Hellons-Dev/DoRobo-M2Project/Electronical_Schematic/README.md

# Here is the schematic of the robot and its electronical parts
