Hellons-Dev/DoRobo-M2Project/3D_Models/Tracks_Wheels/README.md

# Tracks and wheel have been found here :
https://www.thingiverse.com/thing:3680093
