Hellons-Dev/DoRobo-M2Project/Codes/FMReceiver/README.md

# Specifications
- FM Module : BRAVO-T868
- Board : STM32-F303K8
- MBed OS version : MBed 2
- Antenna : Antenna 1/4 wave length SMA 90deg 868MHz

# Version Details
- V0.1 : First test of data reading from FM module
- V0.2 : Second test with lot of errors but working half the time
- V1.1 : New technic for data reading on digital pins but not working
- V2.1 : Final version with difficulties to work has the FM module tend to reverse bytes half the time
