Hellons-Dev/DoRobo-M2Project/Codes/Lidar/FinalVersion/README.md

# Specifications
- Lidar : RPLidar A1M8
- Board : STM32-F446RE
- Library works with all RPLidar versions
