Hellons-Dev/DoRobo-M2Project/Documentations/RPLidarA1M8/README.md

# Link to part :
https://www.gotronic.fr/art-capteur-de-distance-rplidar-a1m8-29031.htm
