Hellons-Dev/DoRobo-M2Project/Documentations/STM32-L476RG/README.md

# Link to part :
https://fr.rs-online.com/web/p/outils-de-developpement-pour-microcontroleurs/8967721

# MBed Link :
https://os.mbed.com/platforms/ST-Nucleo-L476RG/
