Hellons-Dev/DoRobo-M2Project/Documentations/STM32-F446RE/README.md

# Link to part :
https://fr.rs-online.com/web/p/outils-de-developpement-pour-microcontroleurs/9064624/?sra=pmpn

# MBed Link :
https://os.mbed.com/platforms/ST-Nucleo-F446RE/
