Hellons-Dev/DoRobo-M2Project/Documentations/STM32-F303K8/README.md

# Link to part :
https://fr.rs-online.com/web/p/outils-de-developpement-pour-microcontroleurs/9092862

# MBed Link :
https://os.mbed.com/platforms/ST-Nucleo-F303K8/
