Hellons-Dev/DoRobo-M2Project/Documentations/Antenna/README.md

# Link to part :
https://fr.rs-online.com/web/p/antennes-de-telemetrie/0542563
