Hellons-Dev/DoRobo-M2Project/Documentations/PMod_HB3/README.md

# Link to part :
https://fr.rs-online.com/web/p/modules-de-developpement-pour-la-robotique-la-gestion-d-alimentation-et-les-moteurs/1346445
