Hellons-Dev/DoRobo-M2Project/3D_Models/SOLIDWORKS/Assem1.SLDASM

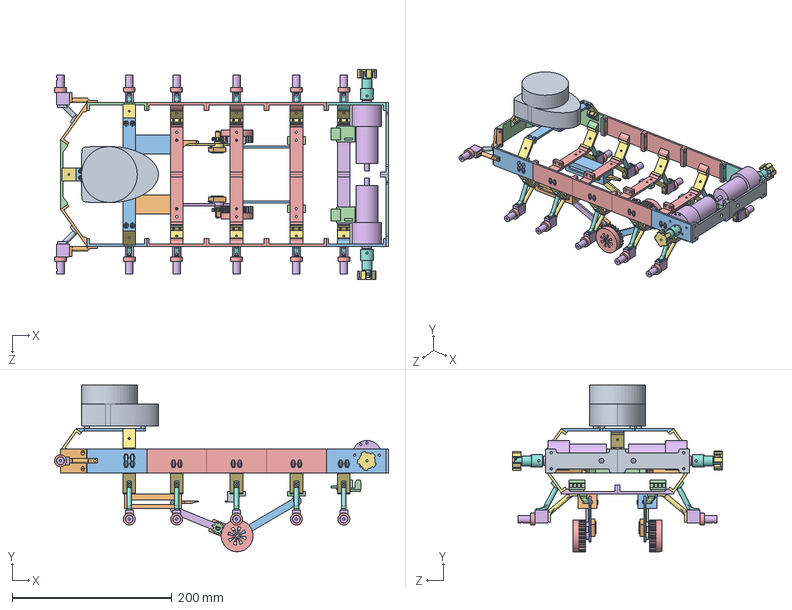
[picture p1: CAD file, 2023-03-26]
3D_Models/SOLIDWORKS/Assem1.SLDASM
418.7 x 208.8 x 263.8 mm
PHMod3 x 2
Robot
EncodingRotor x 2
Robot3 x 2
Robot_mirror
RobotB x 13
RobotBase x 2
Robot2 x 6
Robot4-mirror
Robot4
RobotFront1 x 2
LIDAR
WheelSupport1 x 10
WheelSupport2 x 10
WheelBlockBot x 12
RobotBase2 x 8
lidarBase
WheelSupportFront1 x 2
WheelSupportFront2 x 2
motorWheelAxis x 2
MotorWheelStop x 2
NewMotors x 2
WheelBlockExtender x 12
EncoderSupport1 x 2
Tube
TubeMirror
TubeHold2 x 2
TubeHold1 x 2
ArmENC
ArmENCMirror
SpurGearWheel x 2
SpurGearEnc x 2
ArmSupport x 2
springHolder
springHolder2
