Hellons-Dev/DoRobo-M2Project/3D_Models/SOLIDWORKS/WheelBlockBot.SLDPRT

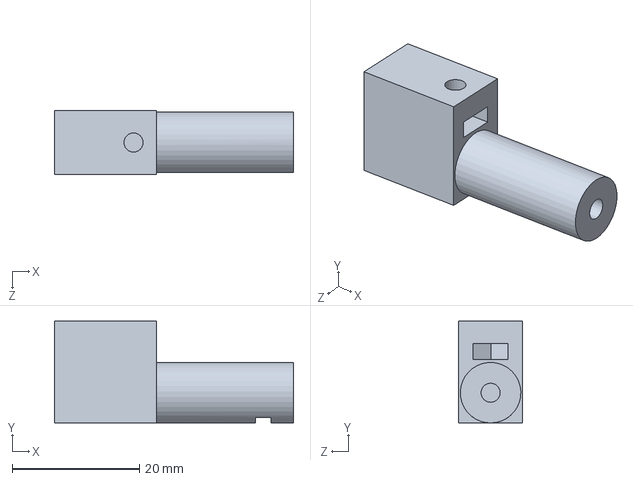
[picture p2: CAD file, 2023-03-26]
3D_Models/SOLIDWORKS/WheelBlockBot.SLDPRT
37.5 x 16.0 x 10.0 mm
