Hellons-Dev/DoRobo-M2Project/3D_Models/SOLIDWORKS/TubeHold2.SLDPRT

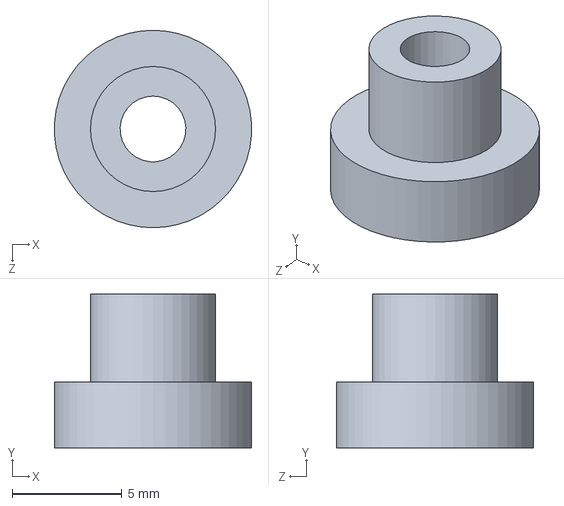
[picture p3: CAD file, 2023-03-26]
3D_Models/SOLIDWORKS/TubeHold2.SLDPRT
8.98 x 7.00 x 9.00 mm
