Hellons-Dev/DoRobo-M2Project/3D_Models/SOLIDWORKS/Face.SLDPRT

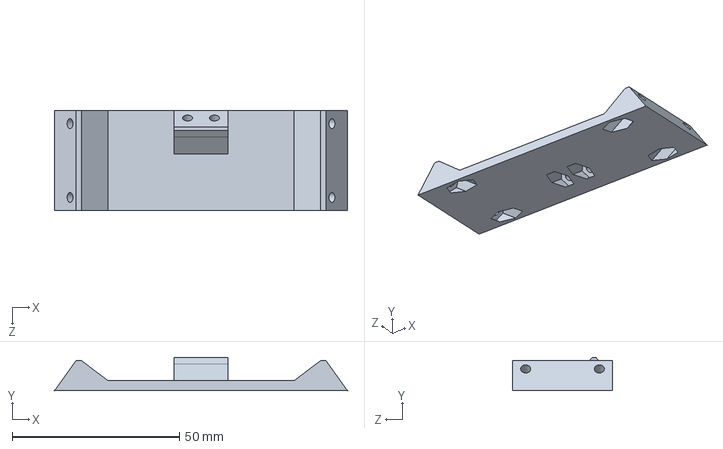
[picture p4: CAD file, 2023-03-26]
3D_Models/SOLIDWORKS/Face.SLDPRT
87.5 x 10.0 x 30.0 mm
