Hellons-Dev/DoRobo-M2Project/3D_Models/SOLIDWORKS/motorWheelAxis.SLDPRT

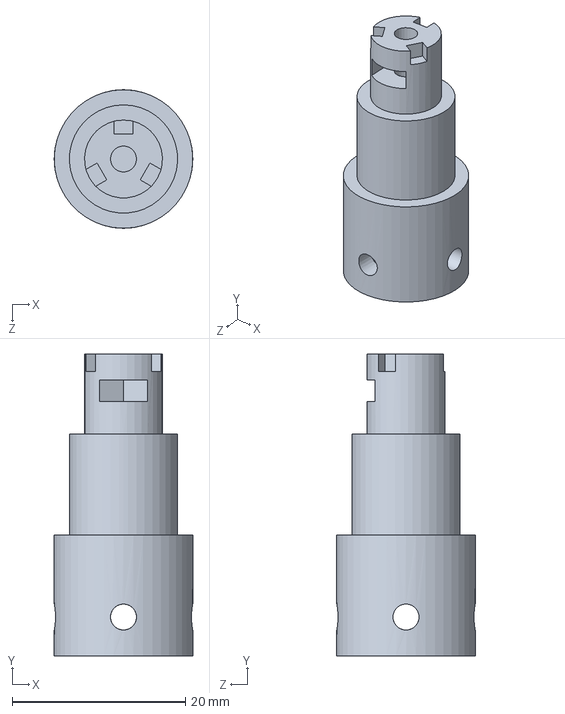
[picture p5: CAD file, 2023-03-26]
3D_Models/SOLIDWORKS/motorWheelAxis.SLDPRT
16.0 x 34.9 x 16.0 mm
