Hellons-Dev/DoRobo-M2Project/3D_Models/SOLIDWORKS/EncoderSupport1.SLDPRT

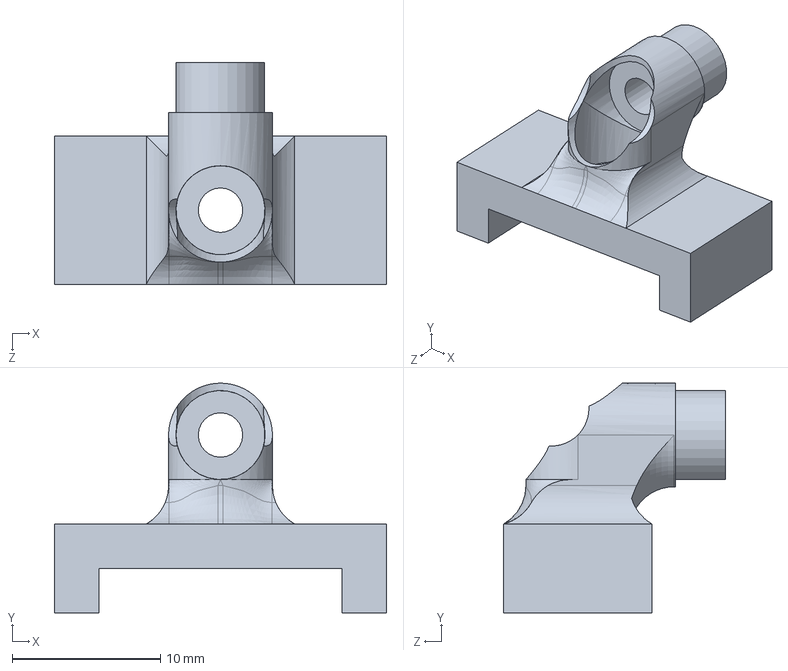
[picture p6: CAD file, 2023-03-26]
3D_Models/SOLIDWORKS/EncoderSupport1.SLDPRT
22.4 x 15.5 x 14.9 mm
