Hellons-Dev/DoRobo-M2Project/3D_Models/SOLIDWORKS/Robot_mirror.SLDPRT

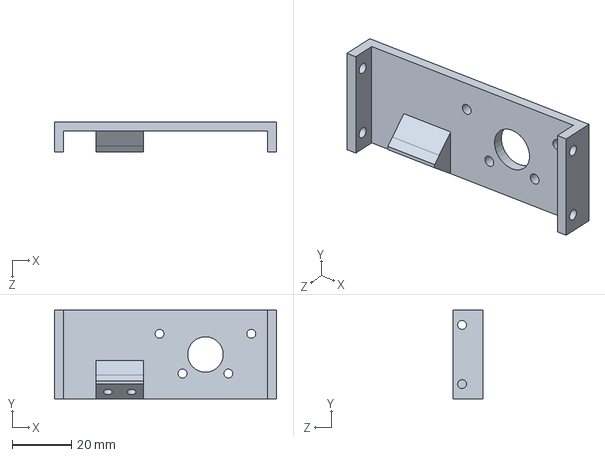
[picture p7: CAD file, 2023-03-26]
3D_Models/SOLIDWORKS/Robot_mirror.SLDPRT
75.0 x 30.0 x 10.0 mm
