Hellons-Dev/DoRobo-M2Project/3D_Models/SOLIDWORKS/WheelBlockExtender.SLDPRT

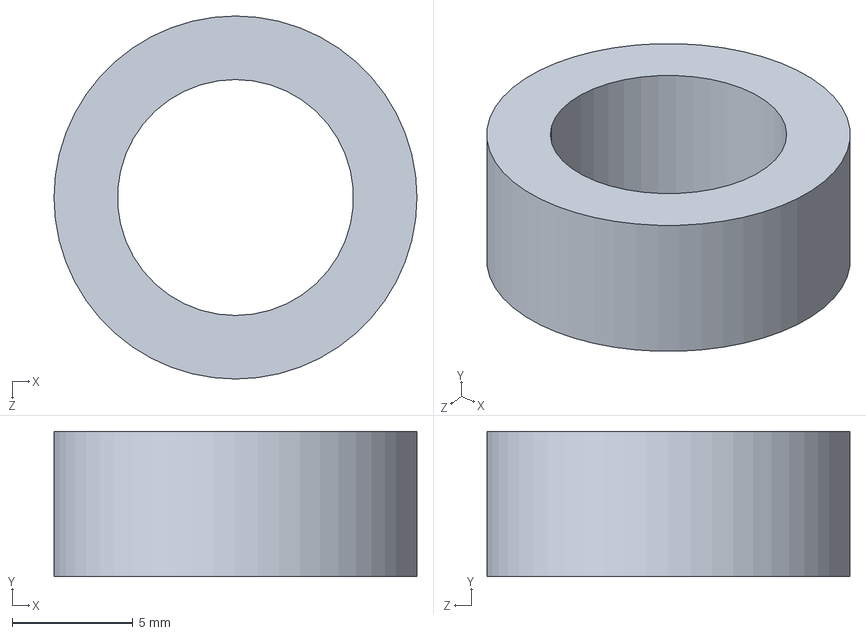
[picture p8: CAD file, 2023-03-26]
3D_Models/SOLIDWORKS/WheelBlockExtender.SLDPRT
15.0 x 6.00 x 15.0 mm
