Hellons-Dev/DoRobo-M2Project/3D_Models/SOLIDWORKS/Tube.SLDPRT

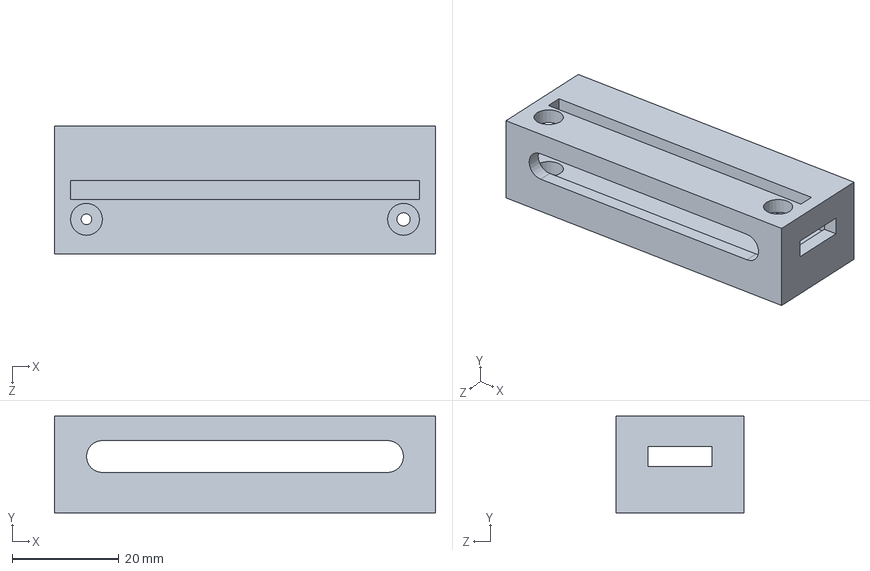
[picture p9: CAD file, 2023-03-26]
3D_Models/SOLIDWORKS/Tube.SLDPRT
71.5 x 18.2 x 24.0 mm
