Hellons-Dev/DoRobo-M2Project/3D_Models/SOLIDWORKS/TubeHold1.SLDPRT

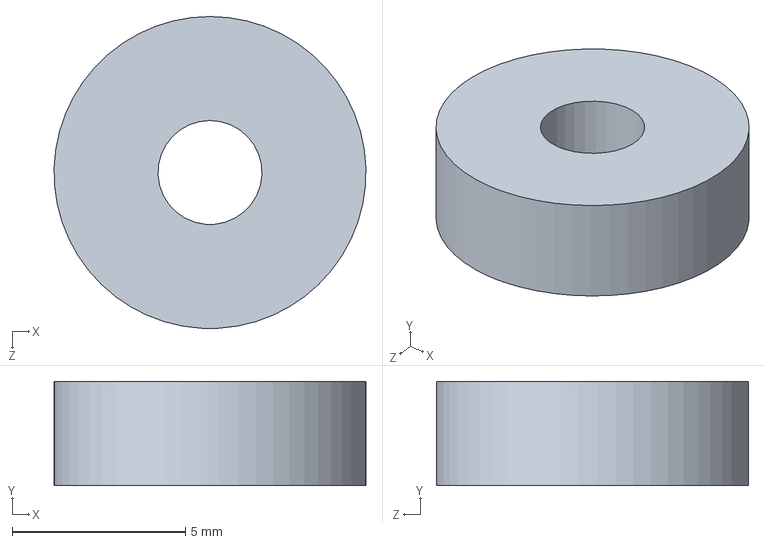
[picture p10: CAD file, 2023-03-26]
3D_Models/SOLIDWORKS/TubeHold1.SLDPRT
9.00 x 3.00 x 9.00 mm
