Hellons-Dev/DoRobo-M2Project/3D_Models/SOLIDWORKS/TubeMirror.SLDPRT

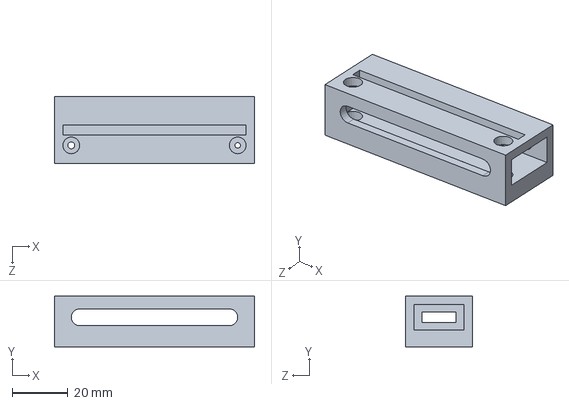
[picture p11: CAD file, 2023-03-26]
3D_Models/SOLIDWORKS/TubeMirror.SLDPRT
71.5 x 18.2 x 24.0 mm
