Hellons-Dev/DoRobo-M2Project/3D_Models/SOLIDWORKS/SpurGearWheel.SLDPRT

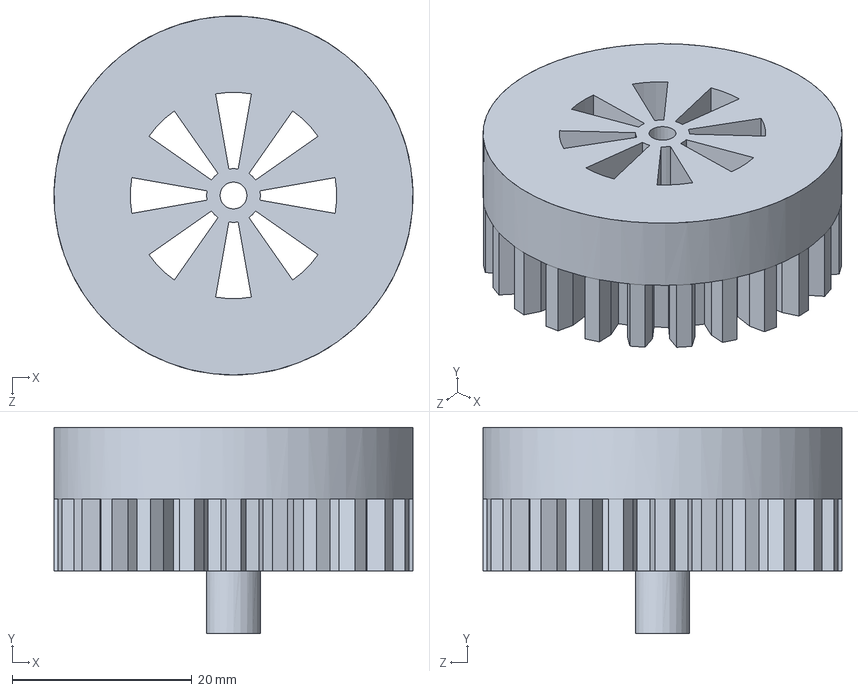
[picture p12: CAD file, 2023-03-26]
3D_Models/SOLIDWORKS/SpurGearWheel.SLDPRT
40.0 x 23.0 x 40.0 mm
