Hellons-Dev/DoRobo-M2Project/3D_Models/SOLIDWORKS/WheelEncHold.SLDPRT

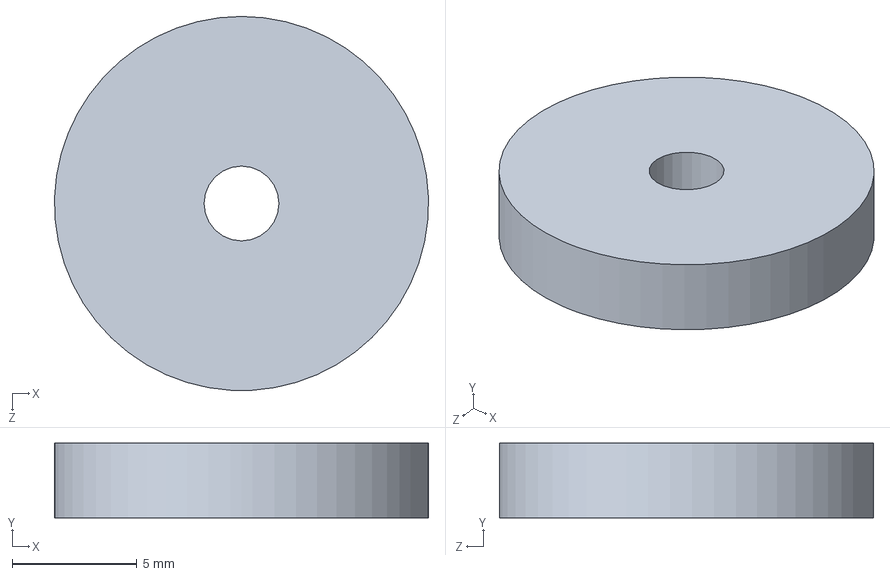
[picture p13: CAD file, 2023-03-26]
3D_Models/SOLIDWORKS/WheelEncHold.SLDPRT
15.0 x 3.00 x 15.0 mm
