Hellons-Dev/DoRobo-M2Project/3D_Models/SOLIDWORKS/RobotBase.SLDPRT

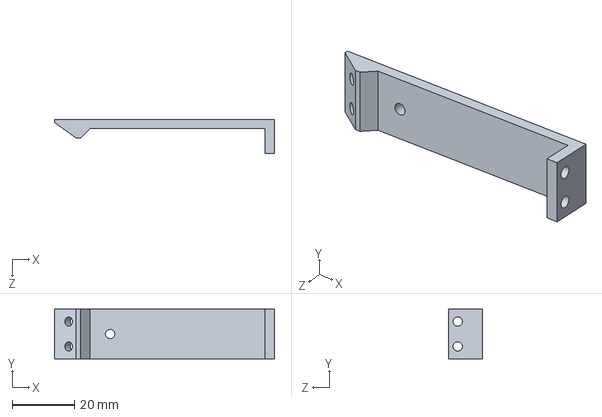
[picture p14: CAD file, 2023-03-26]
3D_Models/SOLIDWORKS/RobotBase.SLDPRT
70.8 x 16.0 x 11.0 mm
