Hellons-Dev/DoRobo-M2Project/3D_Models/SOLIDWORKS/NewMotors.SLDPRT

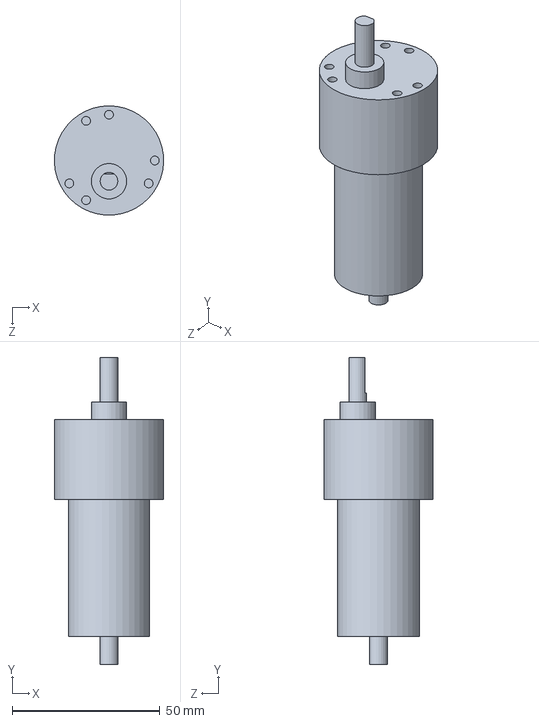
[picture p15: CAD file, 2023-03-26]
3D_Models/SOLIDWORKS/NewMotors.SLDPRT
37.0 x 103.9 x 37.0 mm
