Hellons-Dev/DoRobo-M2Project/3D_Models/SOLIDWORKS/Robot3.SLDPRT

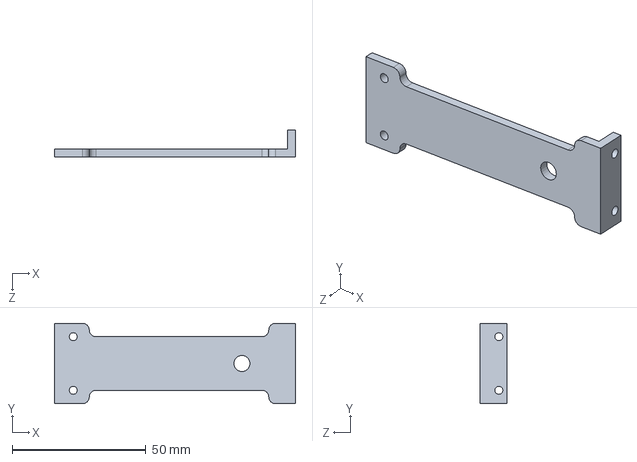
[picture p16: CAD file, 2023-03-26]
3D_Models/SOLIDWORKS/Robot3.SLDPRT
90.0 x 30.0 x 10.0 mm
