Hellons-Dev/DoRobo-M2Project/3D_Models/SOLIDWORKS/WheelStop.SLDPRT

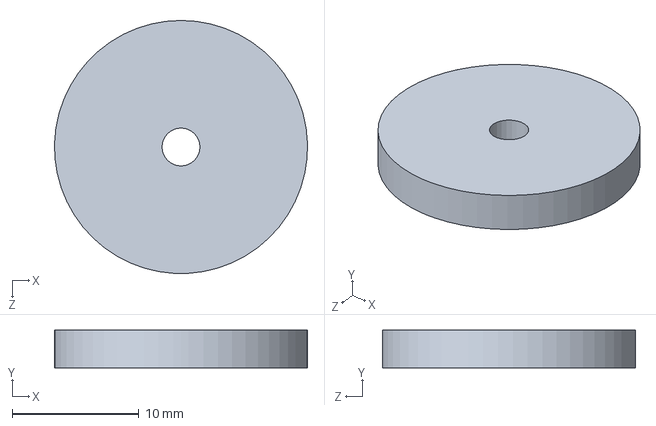
[picture p17: CAD file, 2023-03-26]
3D_Models/SOLIDWORKS/WheelStop.SLDPRT
20.0 x 3.00 x 20.0 mm
