Hellons-Dev/DoRobo-M2Project/3D_Models/SOLIDWORKS/supportArmHolder.SLDPRT

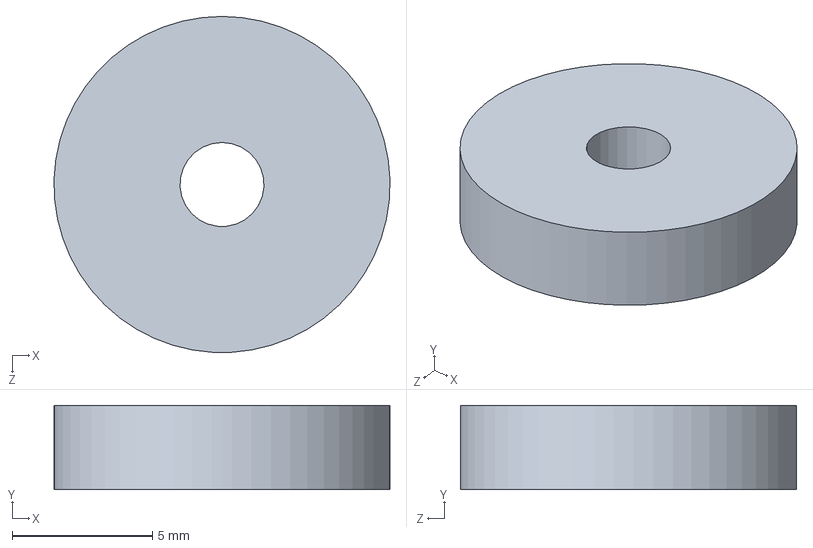
[picture p18: CAD file, 2023-03-26]
3D_Models/SOLIDWORKS/supportArmHolder.SLDPRT
12.0 x 3.00 x 12.0 mm
