Hellons-Dev/DoRobo-M2Project/3D_Models/SOLIDWORKS/springHolder.SLDPRT

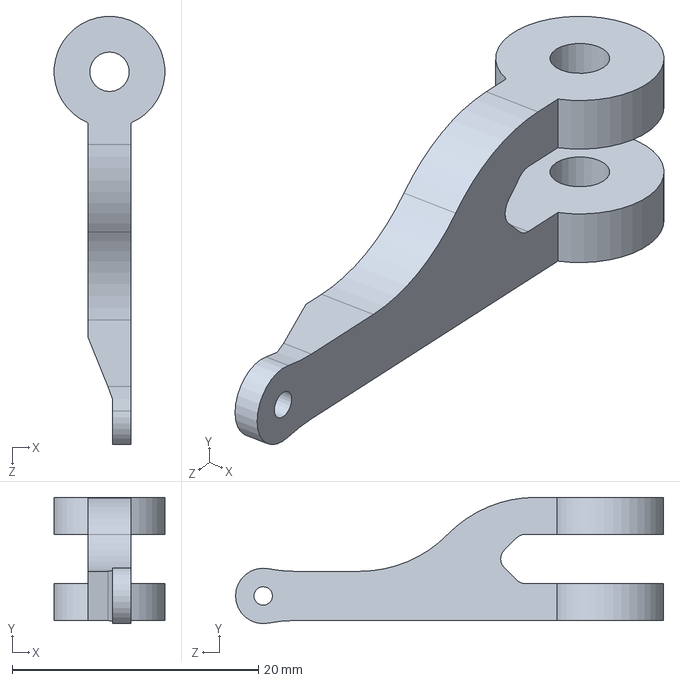
[picture p19: CAD file, 2023-03-26]
3D_Models/SOLIDWORKS/springHolder.SLDPRT
8.98 x 10.2 x 34.7 mm
