Hellons-Dev/DoRobo-M2Project/3D_Models/SOLIDWORKS/springHolder2.SLDPRT

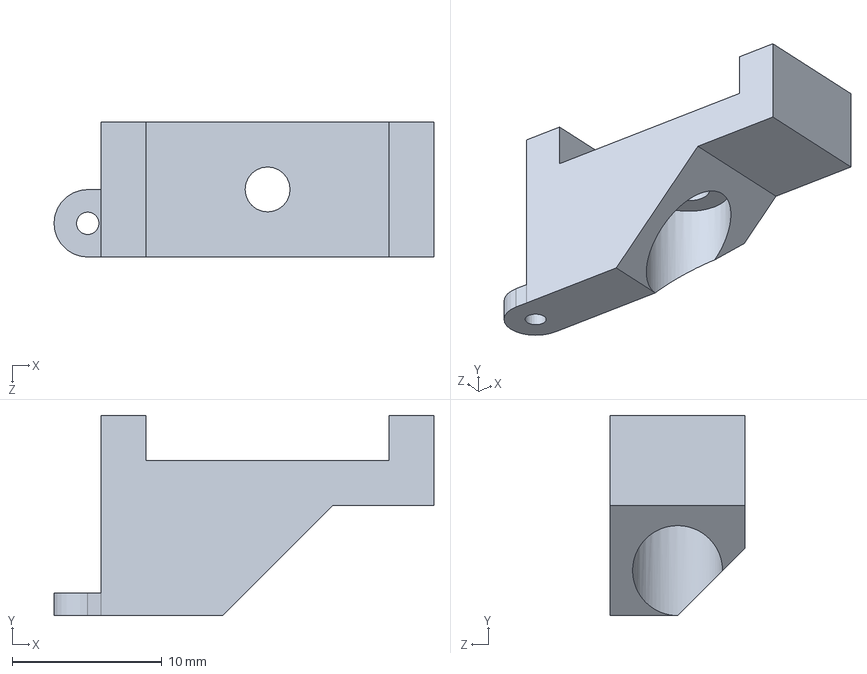
[picture p20: CAD file, 2023-03-26]
3D_Models/SOLIDWORKS/springHolder2.SLDPRT
25.4 x 13.4 x 9.01 mm
