Hellons-Dev/DoRobo-M2Project/3D_Models/SOLIDWORKS/SpurGearEnc.SLDPRT

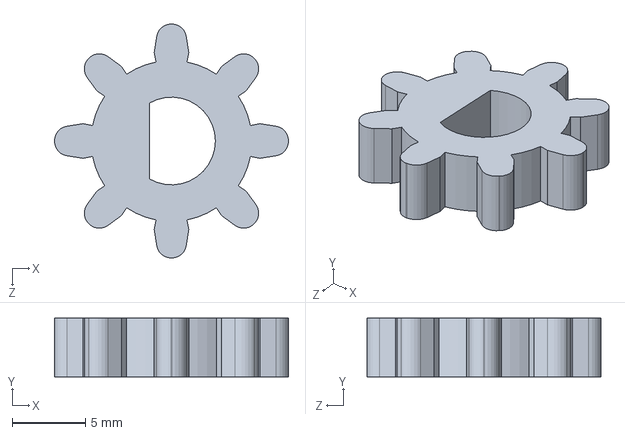
[picture p21: CAD file, 2023-03-26]
3D_Models/SOLIDWORKS/SpurGearEnc.SLDPRT
16.0 x 4.00 x 16.0 mm
