Hellons-Dev/DoRobo-M2Project/3D_Models/SOLIDWORKS/MotorWheelStop.SLDPRT

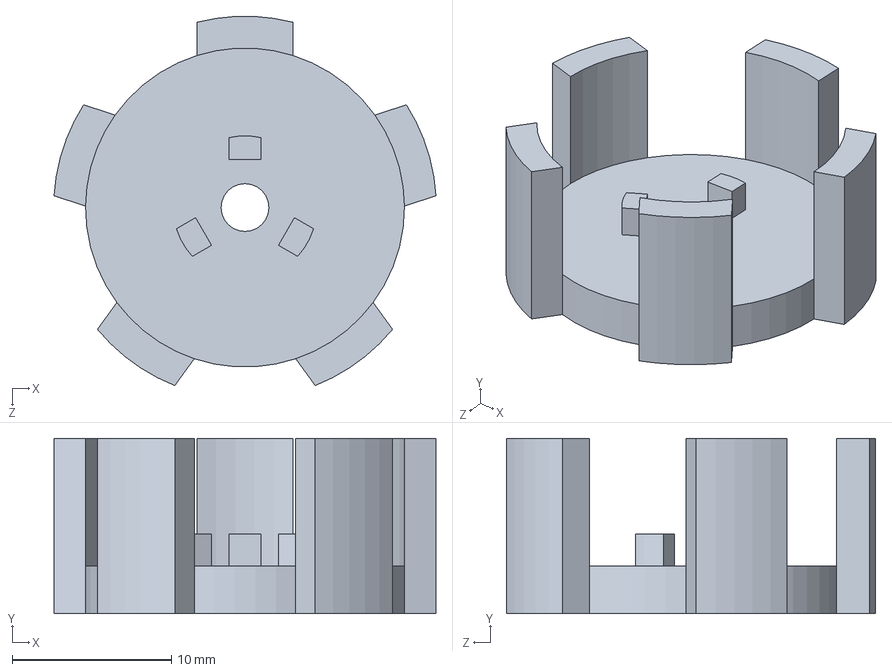
[picture p22: CAD file, 2023-03-26]
3D_Models/SOLIDWORKS/MotorWheelStop.SLDPRT
24.0 x 11.0 x 23.1 mm
