Hellons-Dev/DoRobo-M2Project/3D_Models/SOLIDWORKS/ArmENC.SLDPRT

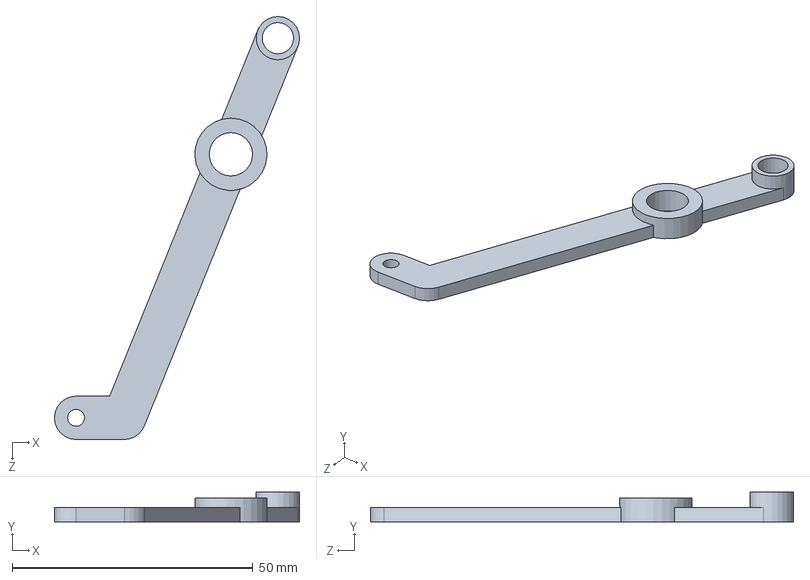
[picture p23: CAD file, 2023-03-26]
3D_Models/SOLIDWORKS/ArmENC.SLDPRT
50.9 x 6.20 x 87.8 mm
