Hellons-Dev/DoRobo-M2Project/3D_Models/SOLIDWORKS/lidarBase.SLDPRT

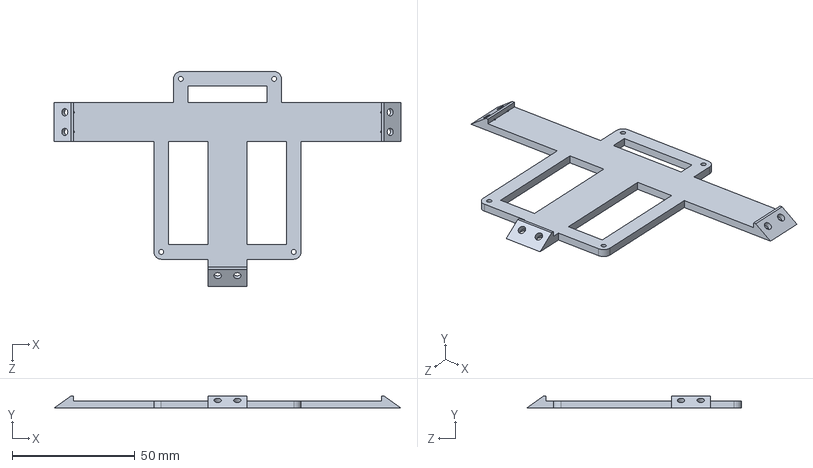
[picture p24: CAD file, 2023-03-26]
3D_Models/SOLIDWORKS/lidarBase.SLDPRT
141.4 x 5.00 x 87.6 mm
