Hellons-Dev/DoRobo-M2Project/3D_Models/SOLIDWORKS/ArmSupport.SLDPRT

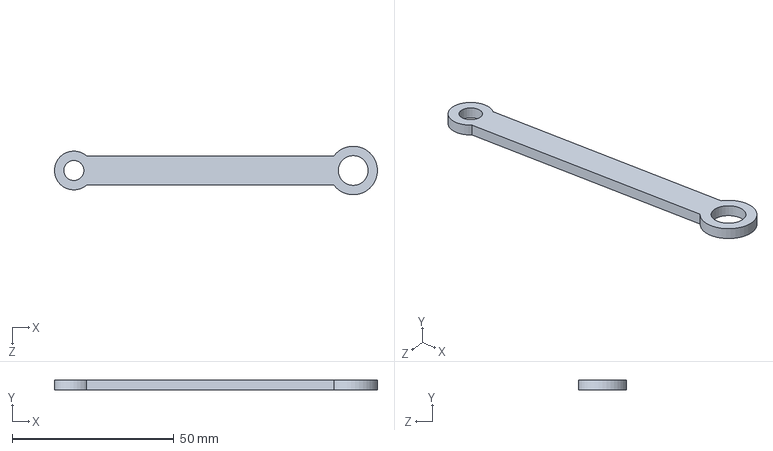
[picture p25: CAD file, 2023-03-26]
3D_Models/SOLIDWORKS/ArmSupport.SLDPRT
99.7 x 3.00 x 15.0 mm
