Hellons-Dev/DoRobo-M2Project/3D_Models/SOLIDWORKS/Robot4-mirror.SLDPRT

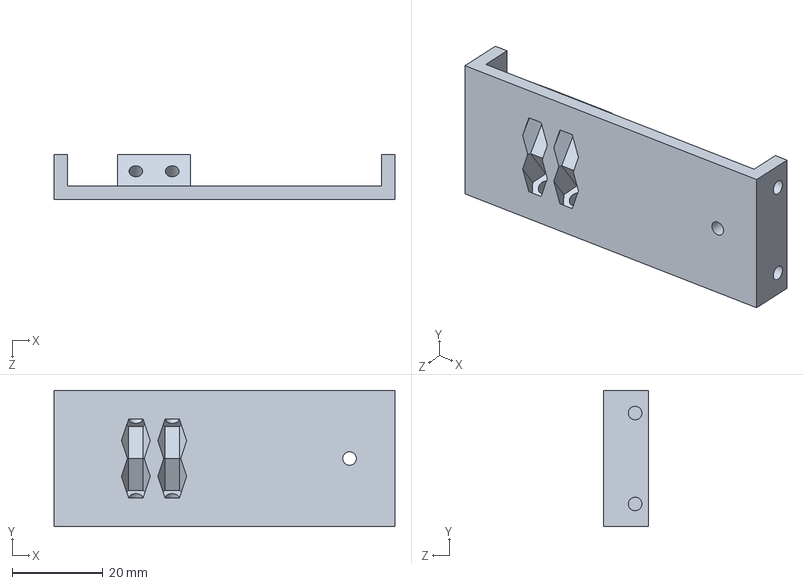
[picture p26: CAD file, 2023-01-04]
3D_Models/SOLIDWORKS/Robot4-mirror.SLDPRT
75.0 x 30.0 x 10.0 mm
