Hellons-Dev/DoRobo-M2Project/3D_Models/SOLIDWORKS/WheelSupportFront1.SLDPRT

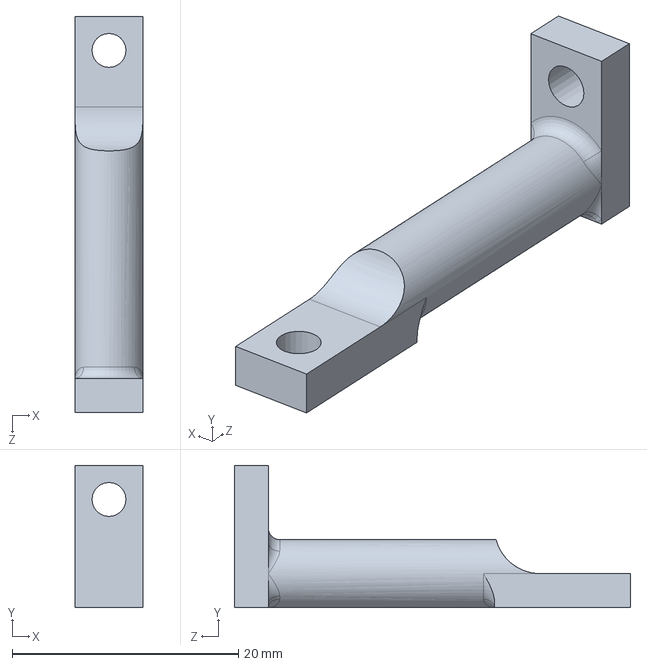
[picture p27: CAD file, 2023-01-04]
3D_Models/SOLIDWORKS/WheelSupportFront1.SLDPRT
6.00 x 12.6 x 35.0 mm
