Hellons-Dev/DoRobo-M2Project/3D_Models/SOLIDWORKS/RobotB.SLDPRT

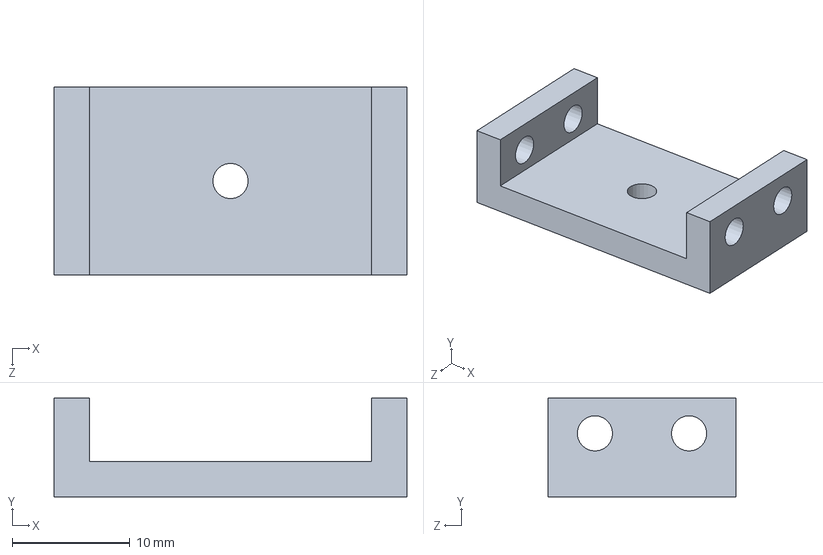
[picture p28: CAD file, 2023-01-04]
3D_Models/SOLIDWORKS/RobotB.SLDPRT
30.0 x 8.40 x 16.0 mm
