Hellons-Dev/DoRobo-M2Project/3D_Models/SOLIDWORKS/WheelSupportFront2.SLDPRT

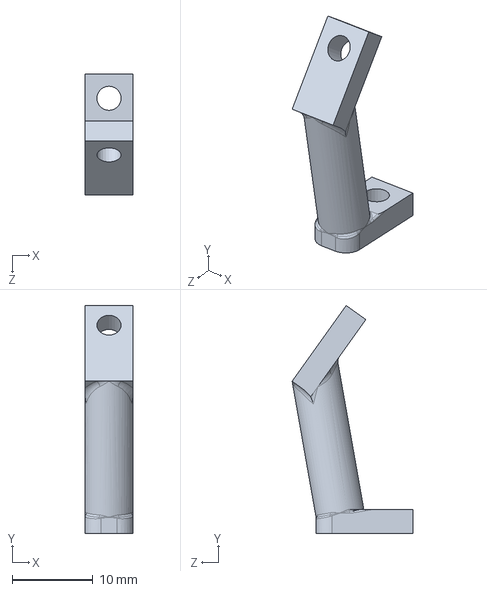
[picture p29: CAD file, 2023-01-04]
3D_Models/SOLIDWORKS/WheelSupportFront2.SLDPRT
6.00 x 28.3 x 15.0 mm
