Hellons-Dev/DoRobo-M2Project/3D_Models/SOLIDWORKS/WheelSupport2.SLDPRT

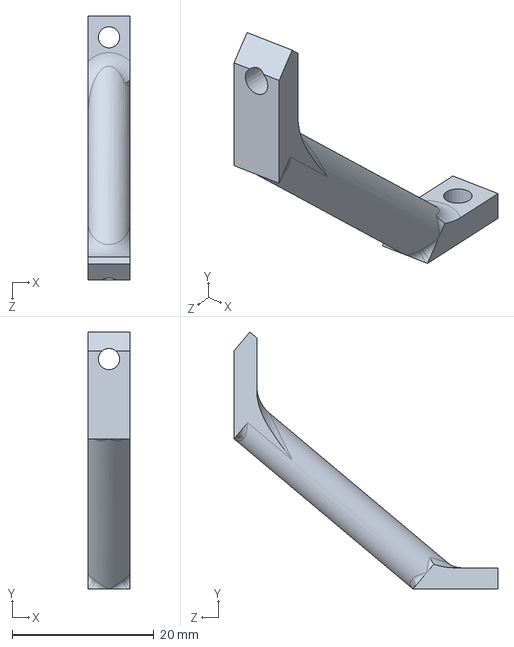
[picture p30: CAD file, 2023-01-04]
3D_Models/SOLIDWORKS/WheelSupport2.SLDPRT
6.00 x 36.3 x 37.3 mm
