Hellons-Dev/DoRobo-M2Project/3D_Models/SOLIDWORKS/LIDAR.SLDPRT

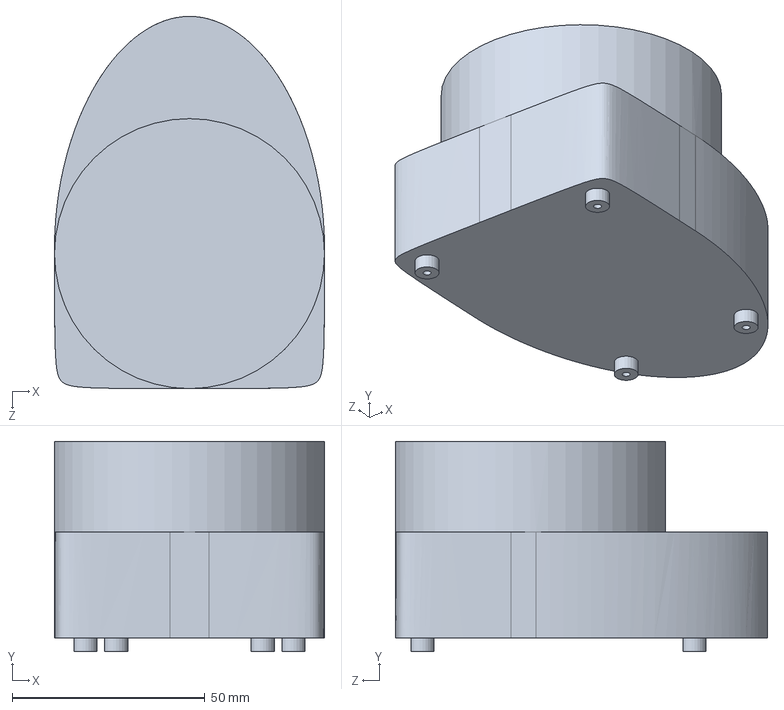
[picture p31: CAD file, 2023-01-04]
3D_Models/SOLIDWORKS/LIDAR.SLDPRT
70.0 x 54.5 x 96.5 mm
