Hellons-Dev/DoRobo-M2Project/3D_Models/SOLIDWORKS/EncodingRotor.SLDPRT

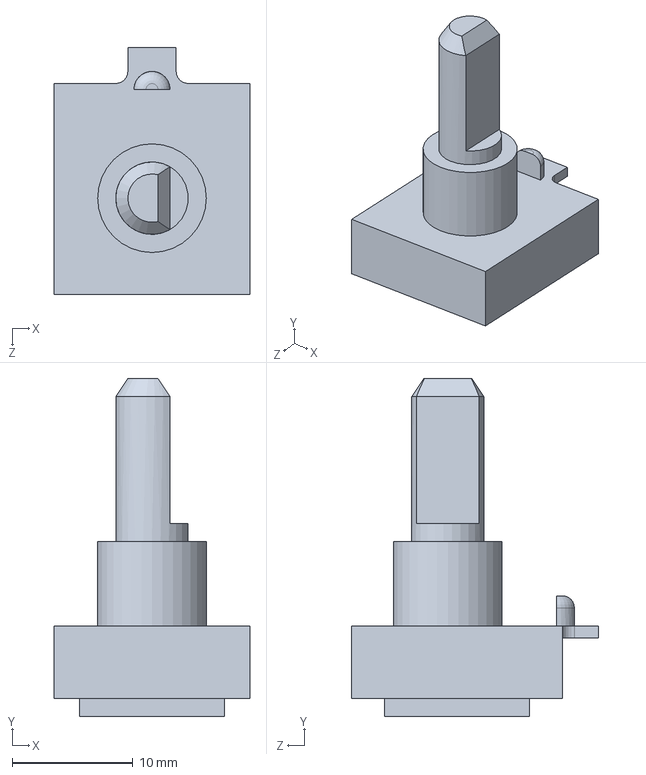
[picture p32: CAD file, 2023-01-04]
3D_Models/SOLIDWORKS/EncodingRotor.SLDPRT
16.2 x 28.0 x 20.5 mm
