Hellons-Dev/DoRobo-M2Project/3D_Models/SOLIDWORKS/RobotFront1.SLDPRT

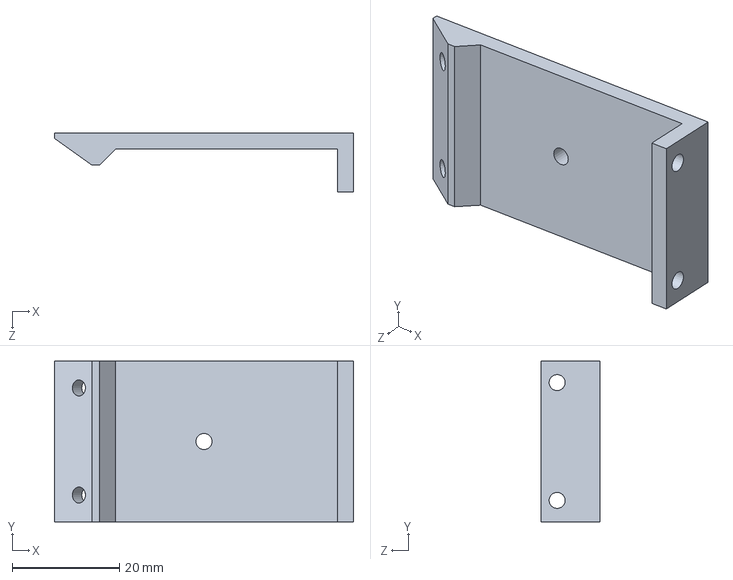
[picture p33: CAD file, 2023-01-04]
3D_Models/SOLIDWORKS/RobotFront1.SLDPRT
55.8 x 30.0 x 11.0 mm
