Hellons-Dev/DoRobo-M2Project/3D_Models/SOLIDWORKS/PHMod3.SLDPRT

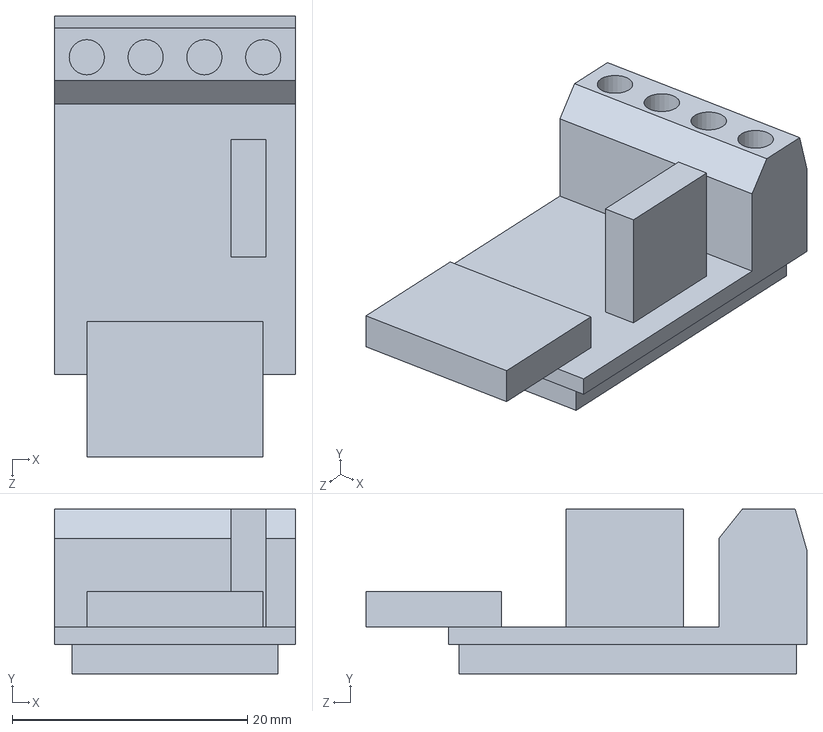
[picture p34: CAD file, 2023-01-04]
3D_Models/SOLIDWORKS/PHMod3.SLDPRT
20.5 x 14.0 x 37.5 mm
