Hellons-Dev/DoRobo-M2Project/3D_Models/SOLIDWORKS/WheelSupport1.SLDPRT

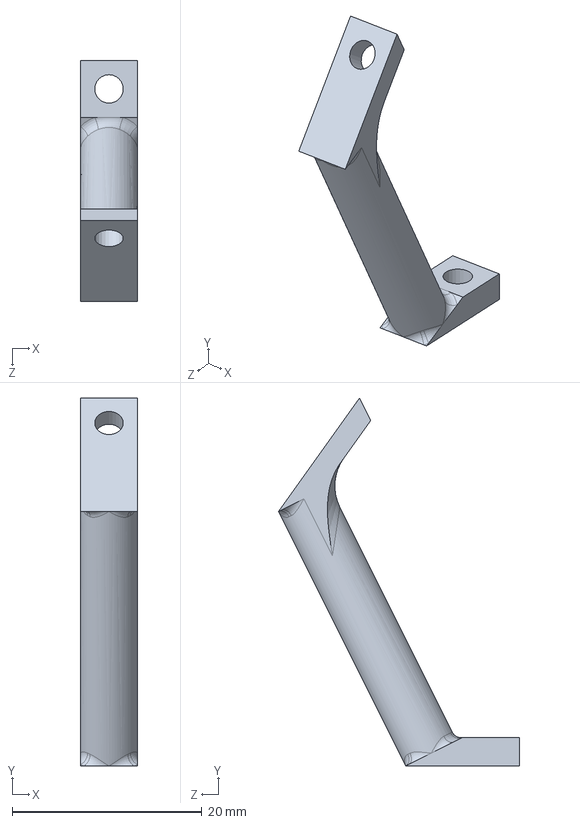
[picture p35: CAD file, 2023-01-04]
3D_Models/SOLIDWORKS/WheelSupport1.SLDPRT
6.00 x 38.8 x 25.4 mm
