Hellons-Dev/DoRobo-M2Project/3D_Models/SOLIDWORKS/Robot2.SLDPRT

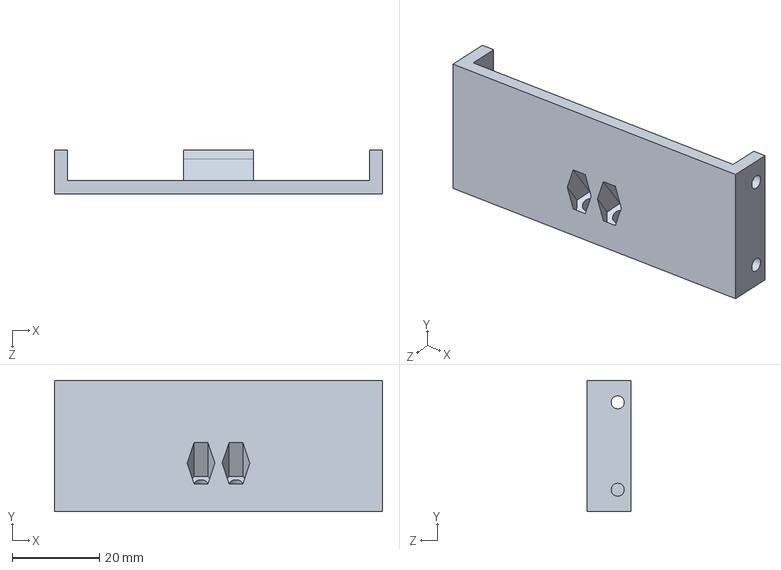
[picture p36: CAD file, 2023-01-04]
3D_Models/SOLIDWORKS/Robot2.SLDPRT
75.0 x 30.0 x 10.0 mm
