Hellons-Dev/DoRobo-M2Project/(list of files, cad)

Other CAD files:
3D_Models/SOLIDWORKS/RobotBase2.SLDPRT
3D_Models/SOLIDWORKS/Robot.SLDPRT
3D_Models/SOLIDWORKS/ArmENCMirror.SLDPRT
3D_Models/SOLIDWORKS/Robot4.SLDPRT
3D_Models/SOLIDWORKS/Screw3-25.SLDPRT
