Hellons-Dev/DoRobo-M2Project/Electronical_Schematic/Schematic_Dorobo_2023-03-29.pdf

## LidarBoard F446RE

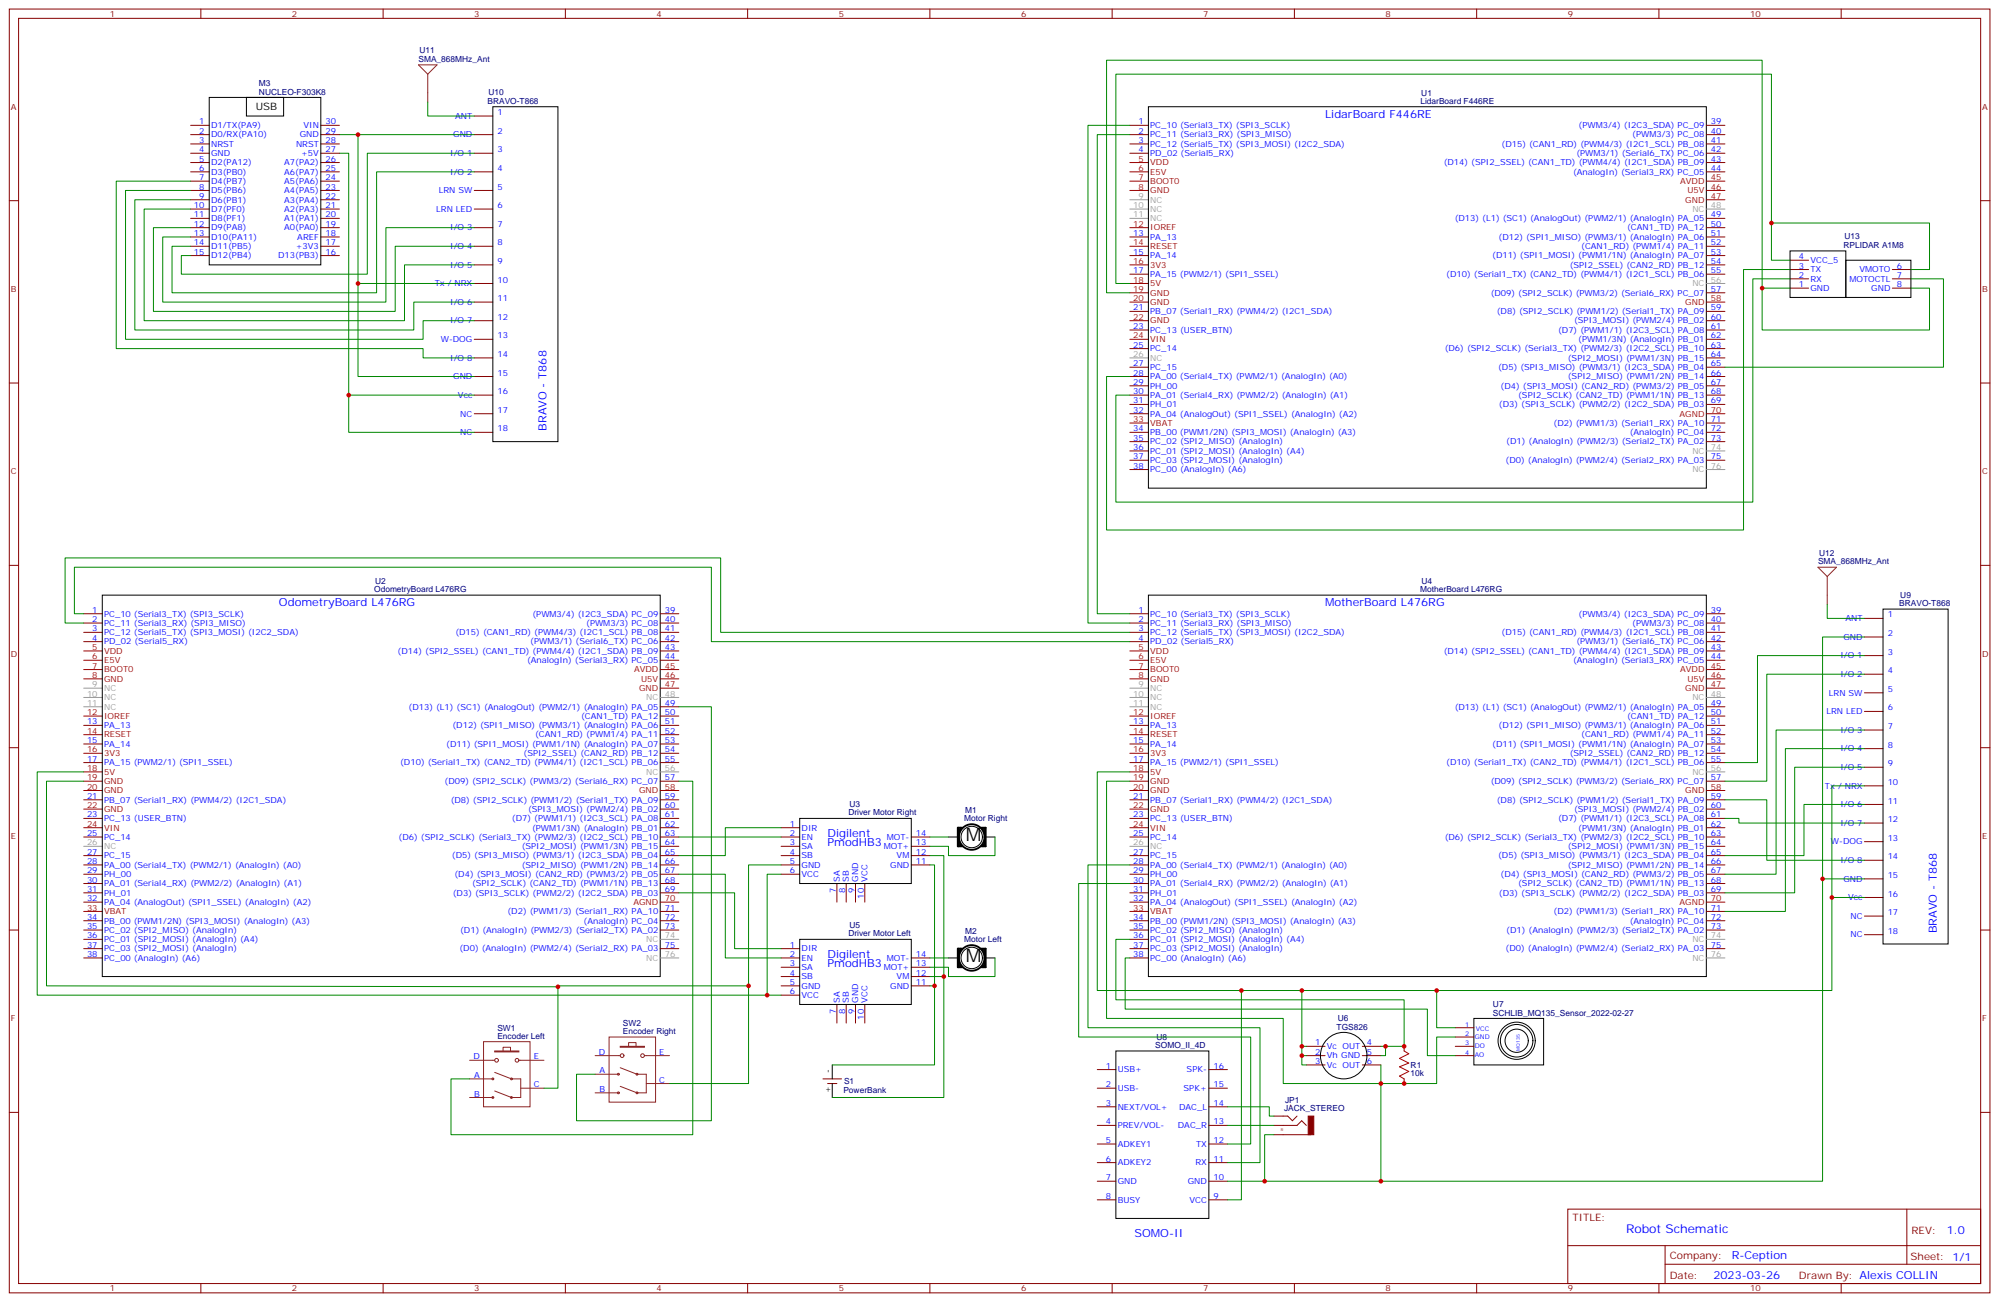
[picture p37: page 1]

Drawn By: Alexis COLLIN

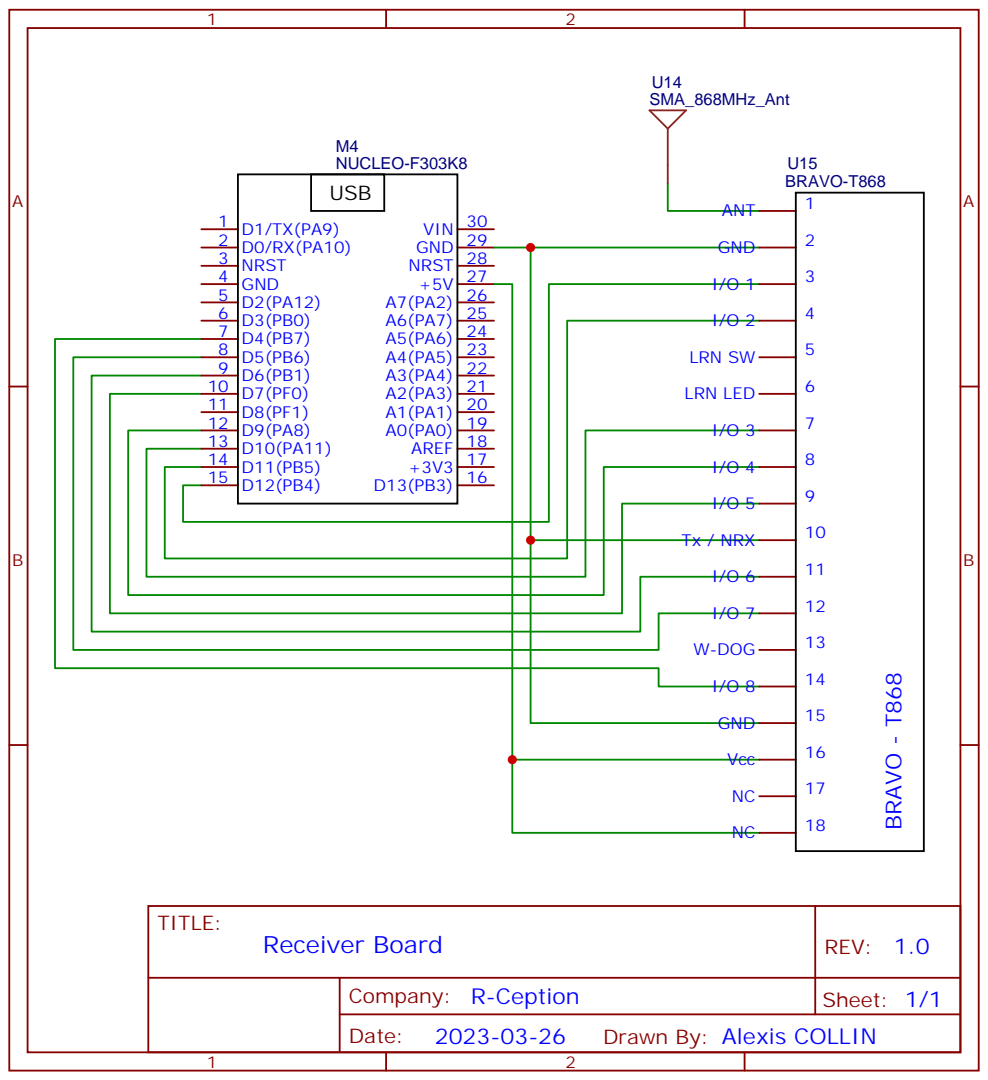
[picture p38: page 2]

## LidarBoard F446RE

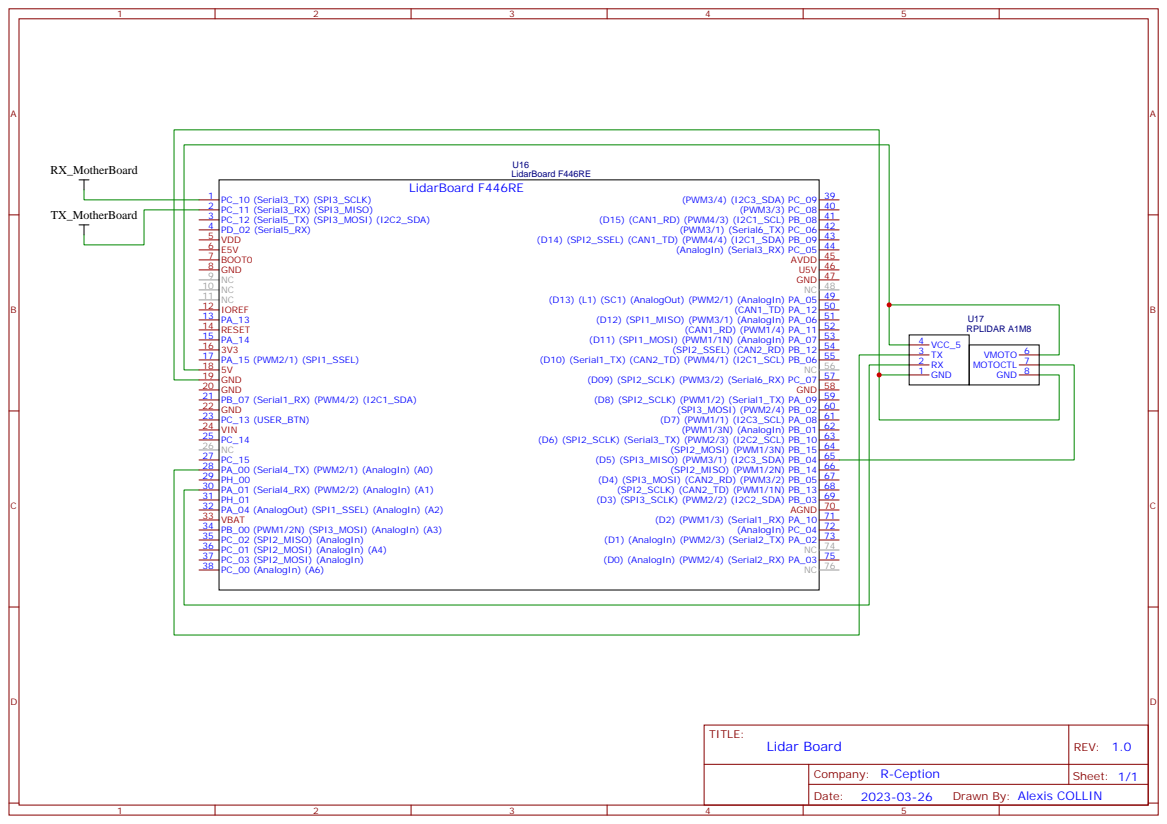
[picture p39: page 3]

## OdometryBoard L476RG

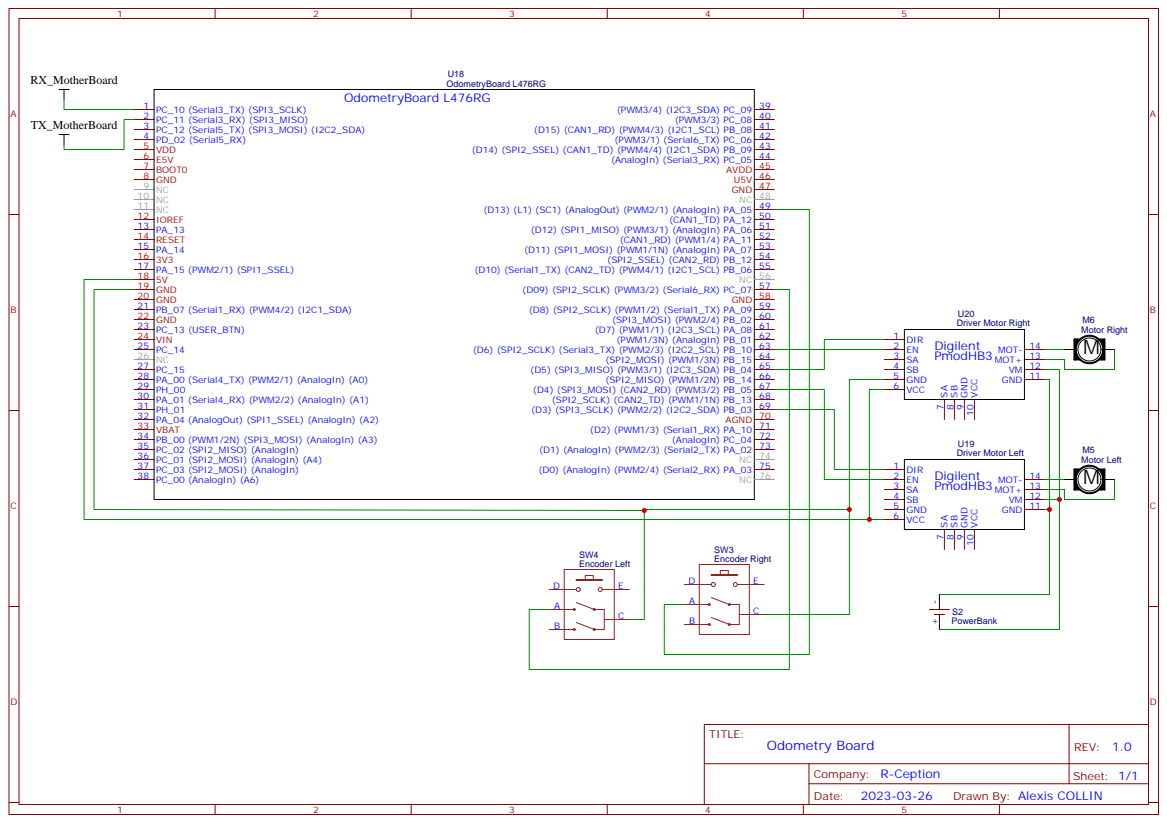
[picture p40: page 4]

## MotherBoard L476RG

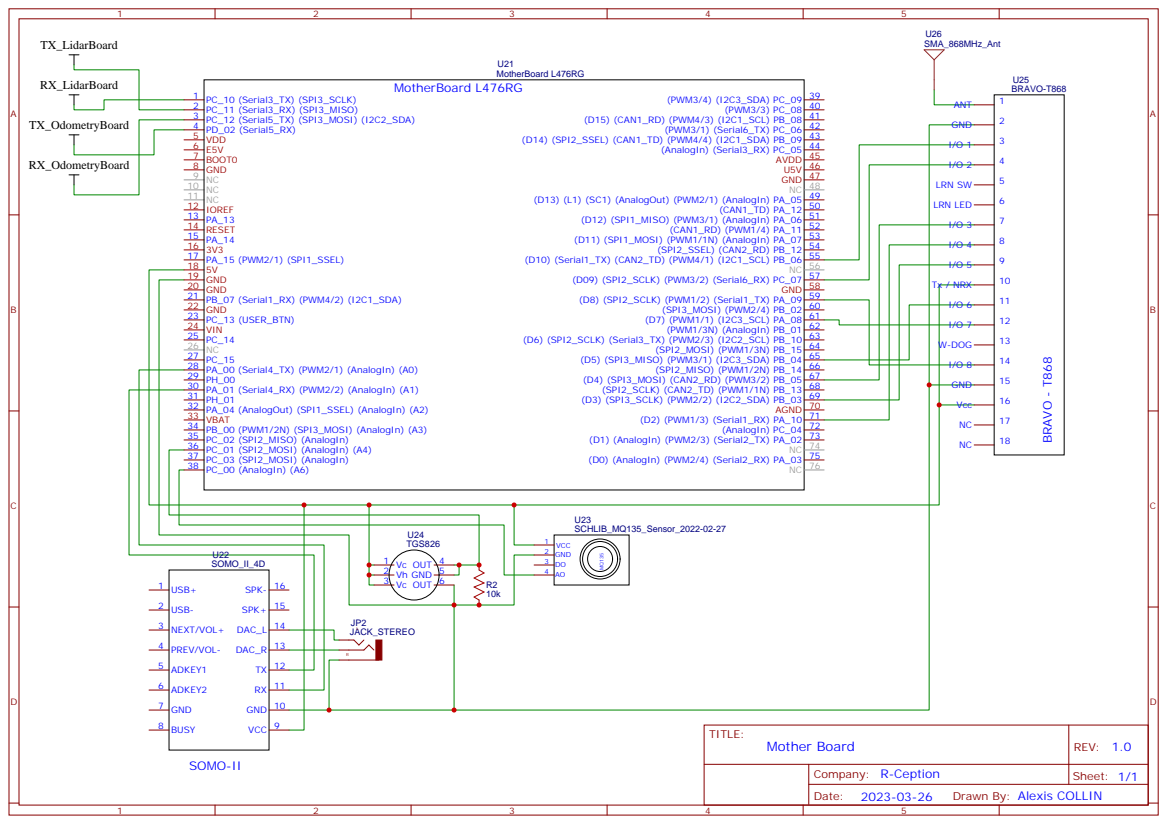
[picture p41: page 5]
