Hellons-Dev/DoRobo-M2Project/Documentations/STM32-F303K8/0900766b81693636.pdf

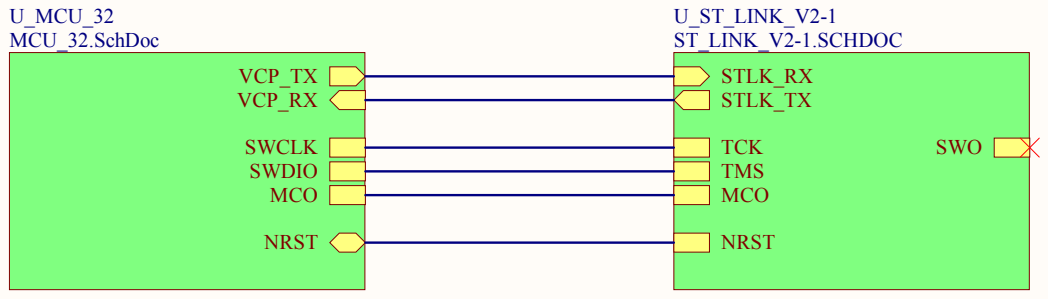
[picture p42: page 1]

REV B: SB14 changed to JP1 Jumper for easy IDD measurement, and enlarge
board length; CN1 USB PN changed to Micro-B for Device.
REV C: Add SB18/SB16 for connecting D4/D5 to A4/A5

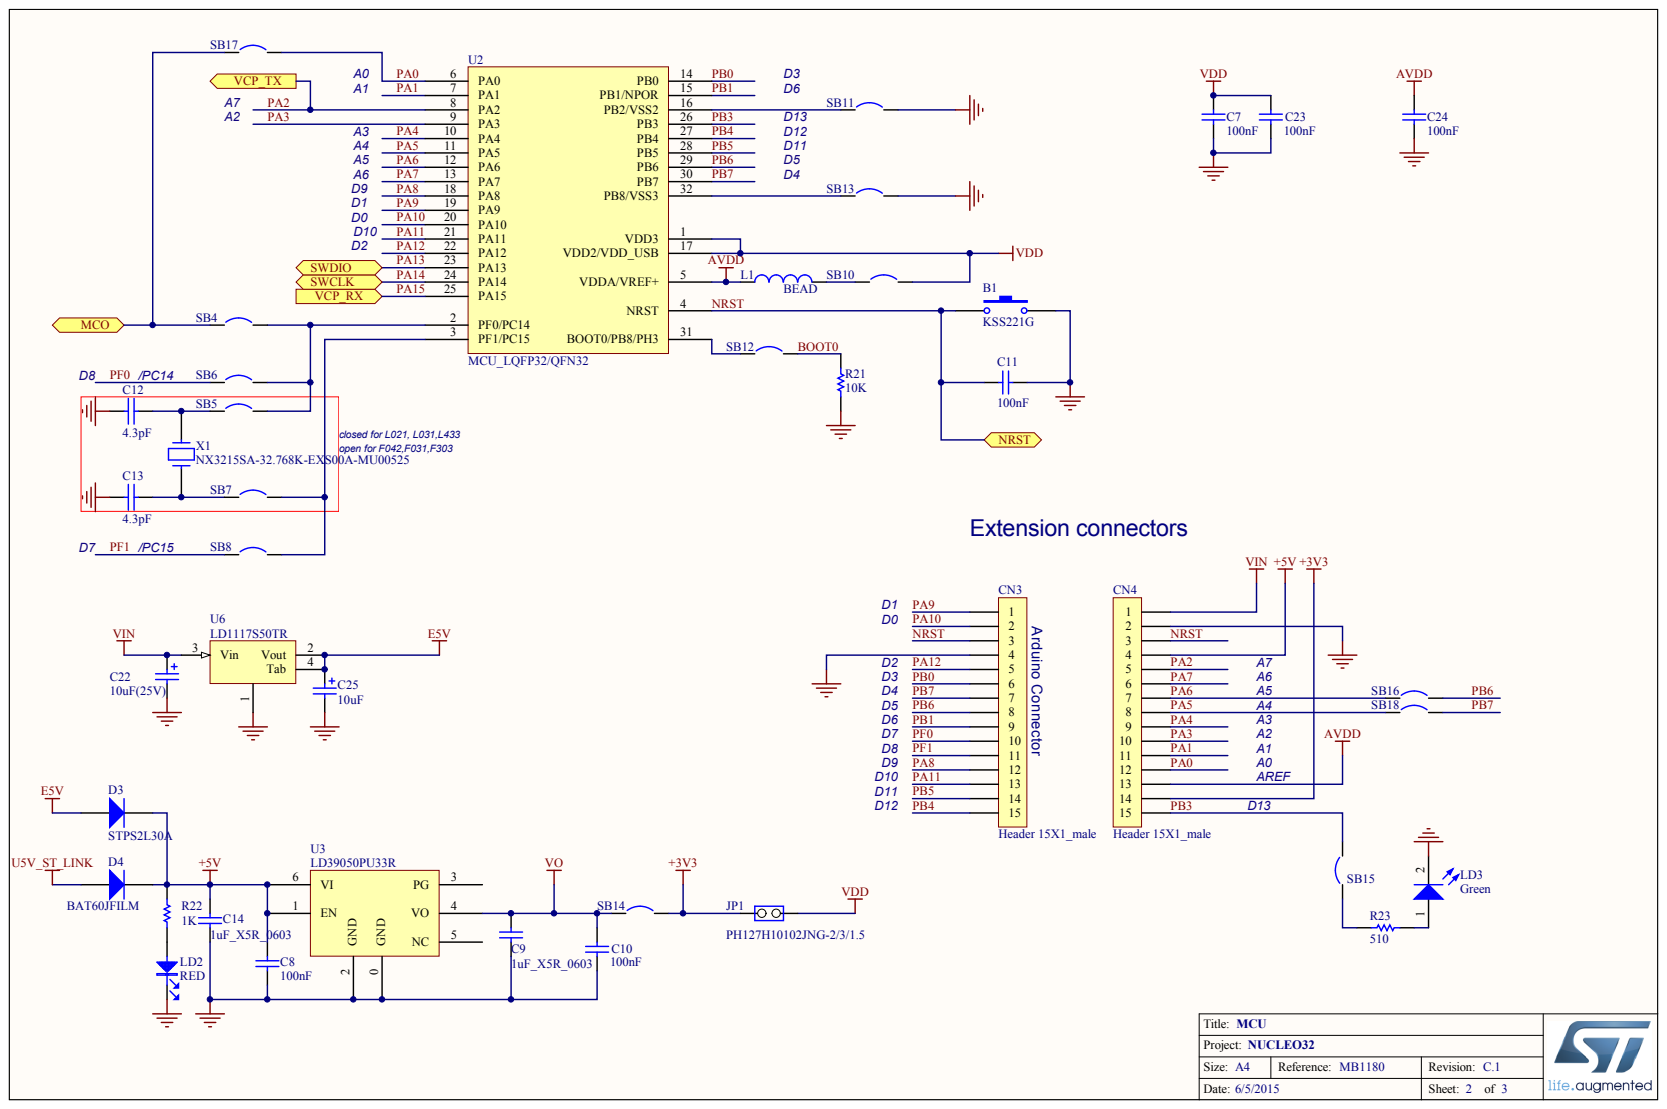
[picture p43: page 2]

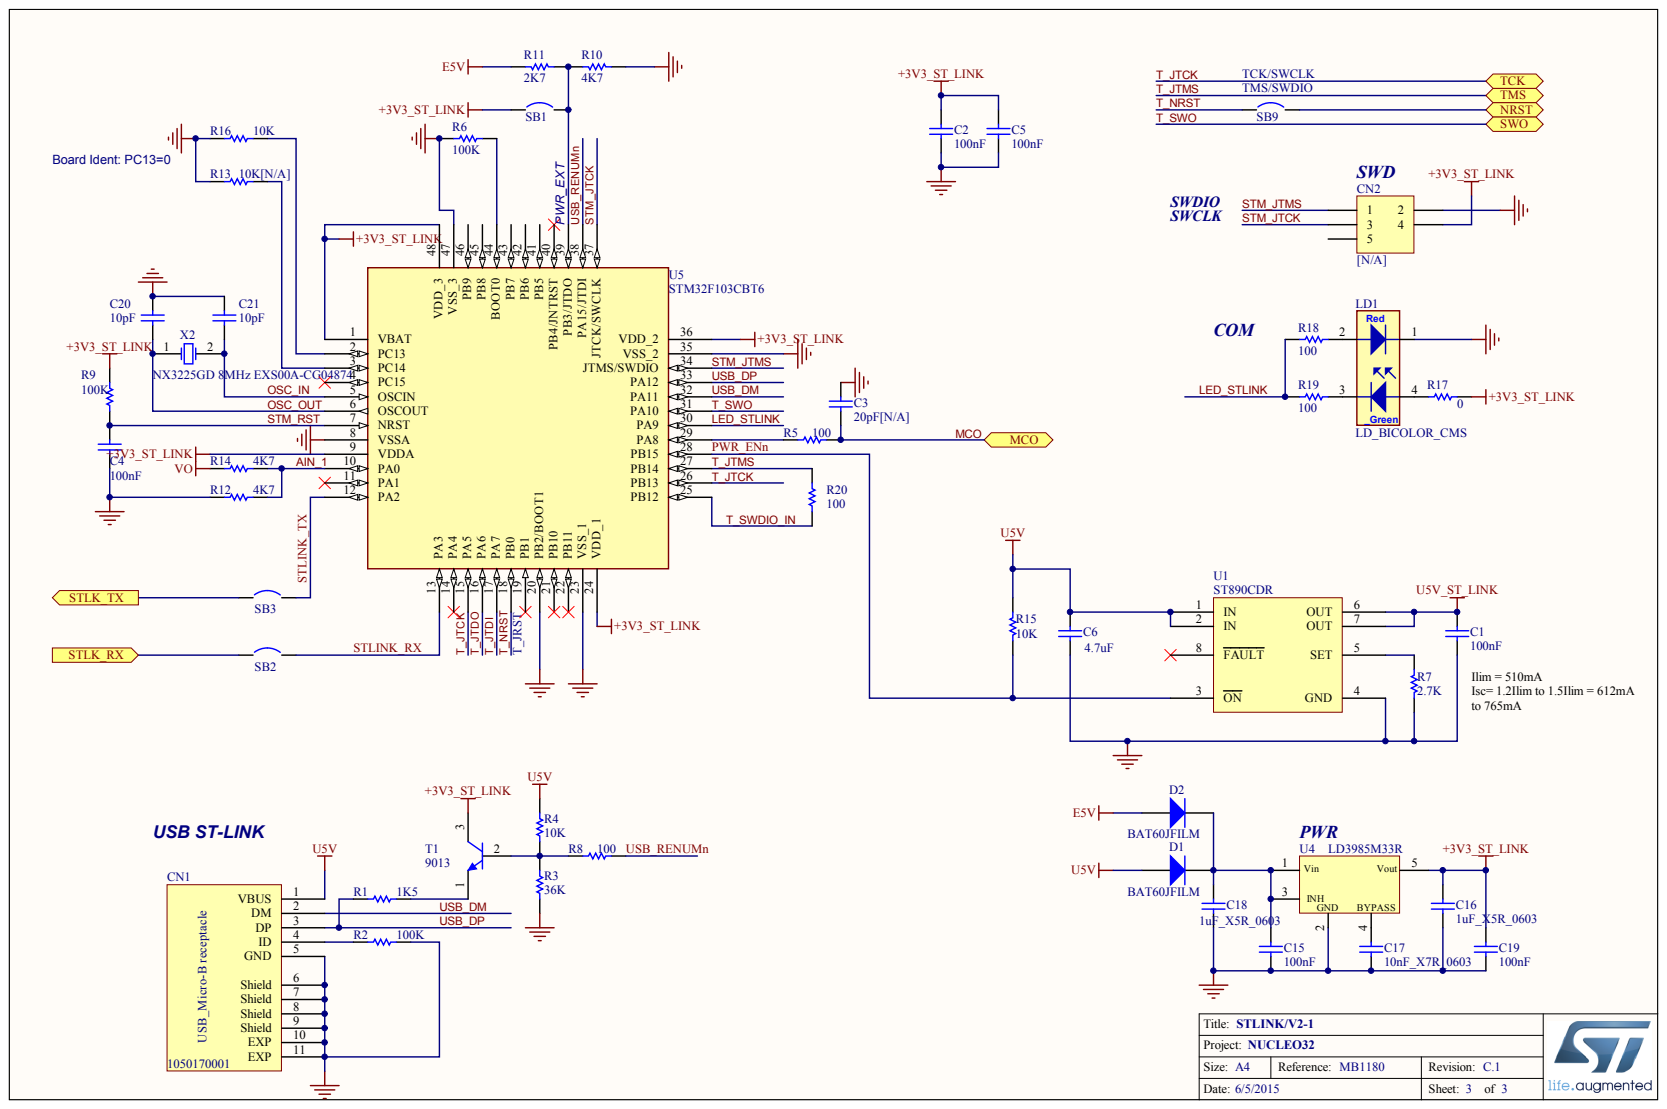
[picture p44: page 3]
